lechk82/ledctrl/schematics/ledctrl.pdf

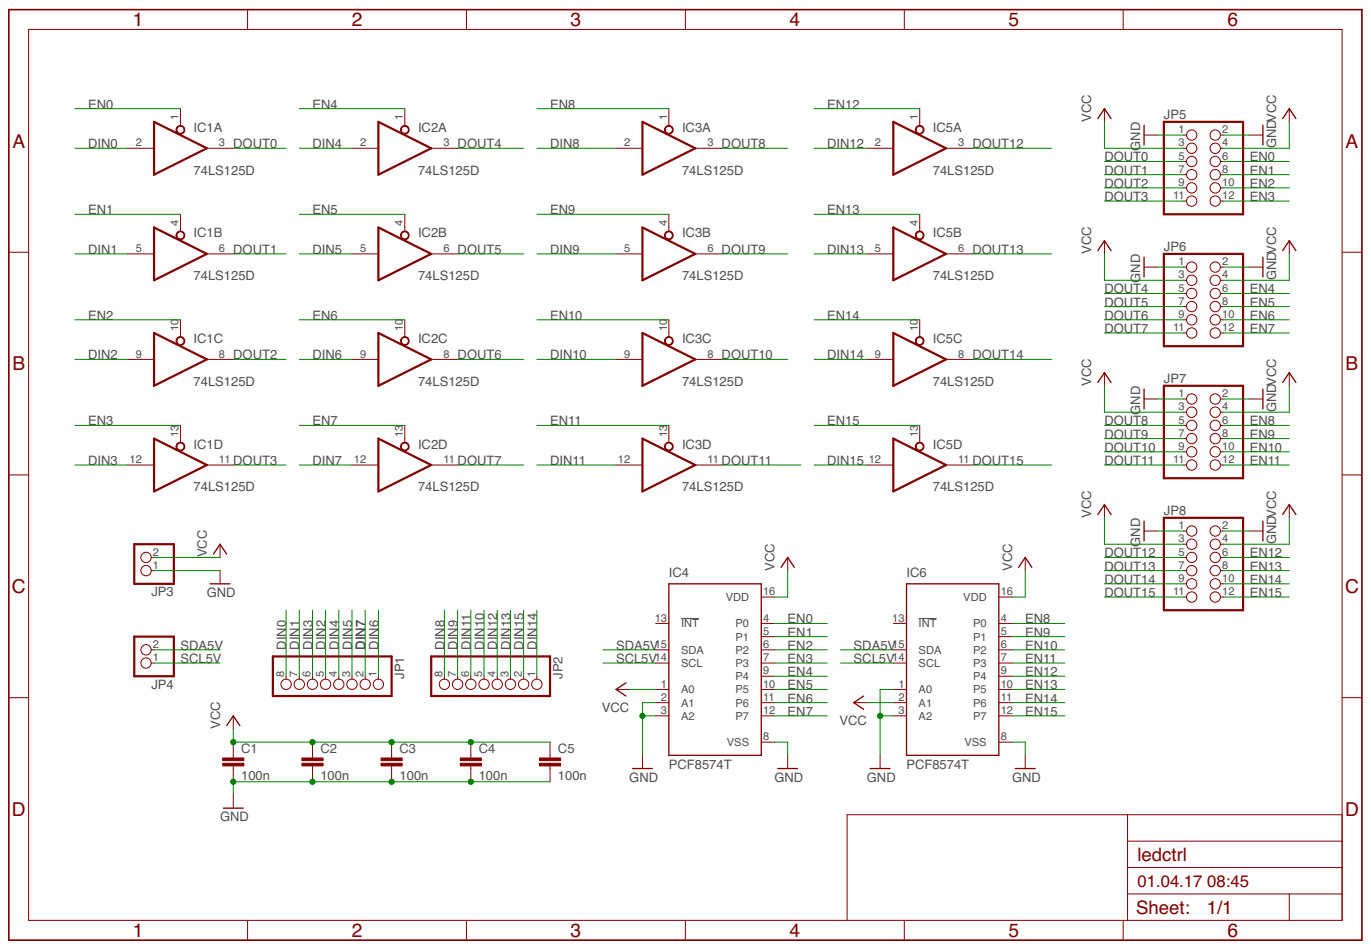
[picture p1: page 1]

GND GND
