lechk82/ledctrl/schematics/ledctrl_carrier.pdf

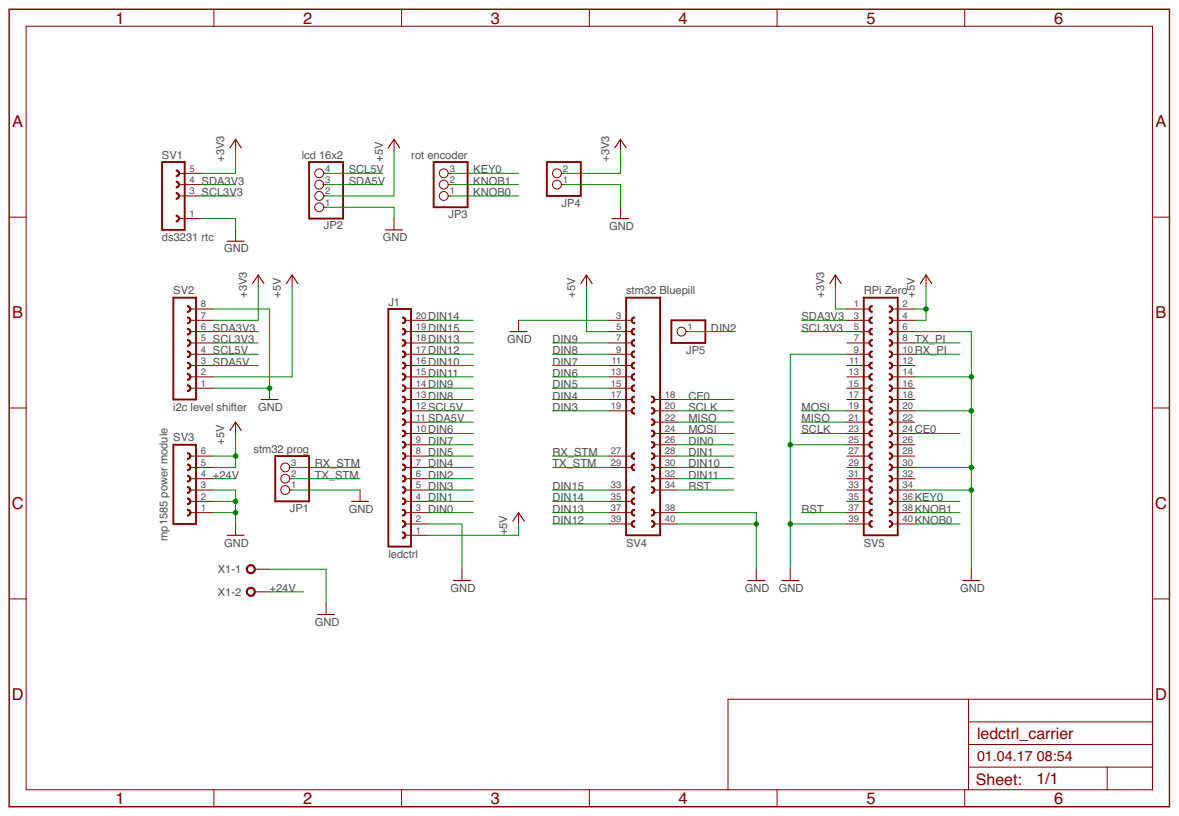
[picture p2: page 1]
