lechk82/ledctrl/schematics/ledctrl_driver.pdf

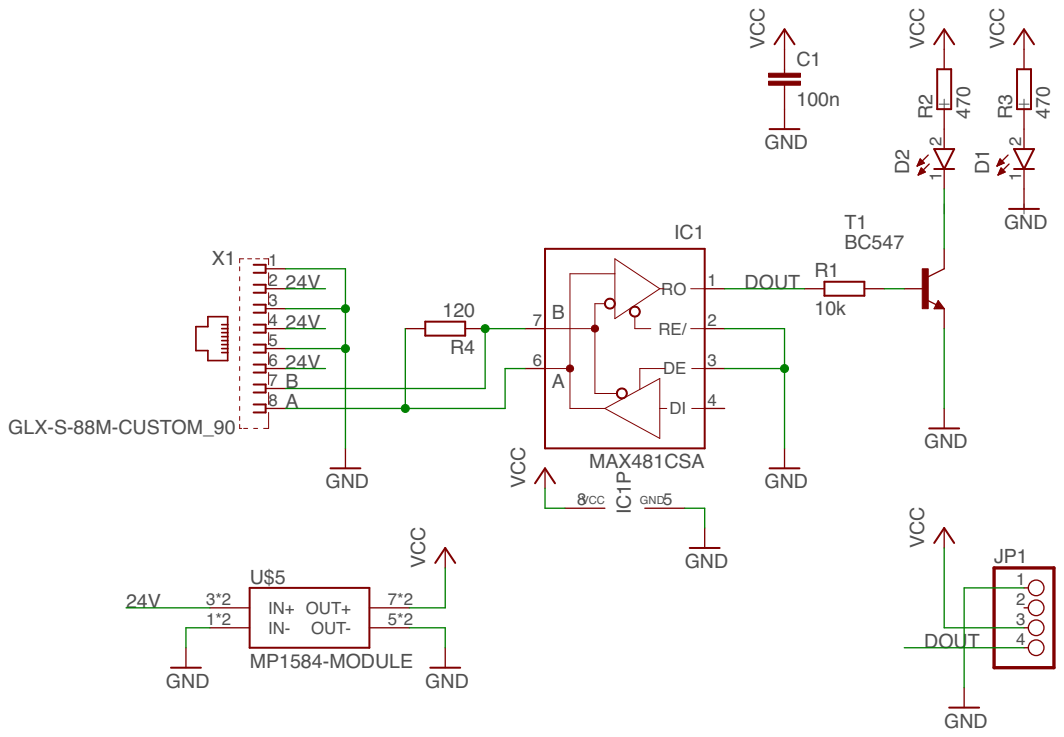
[picture p3: page 1]
