lechk82/ledctrl/schematics/ledctrl_output.pdf

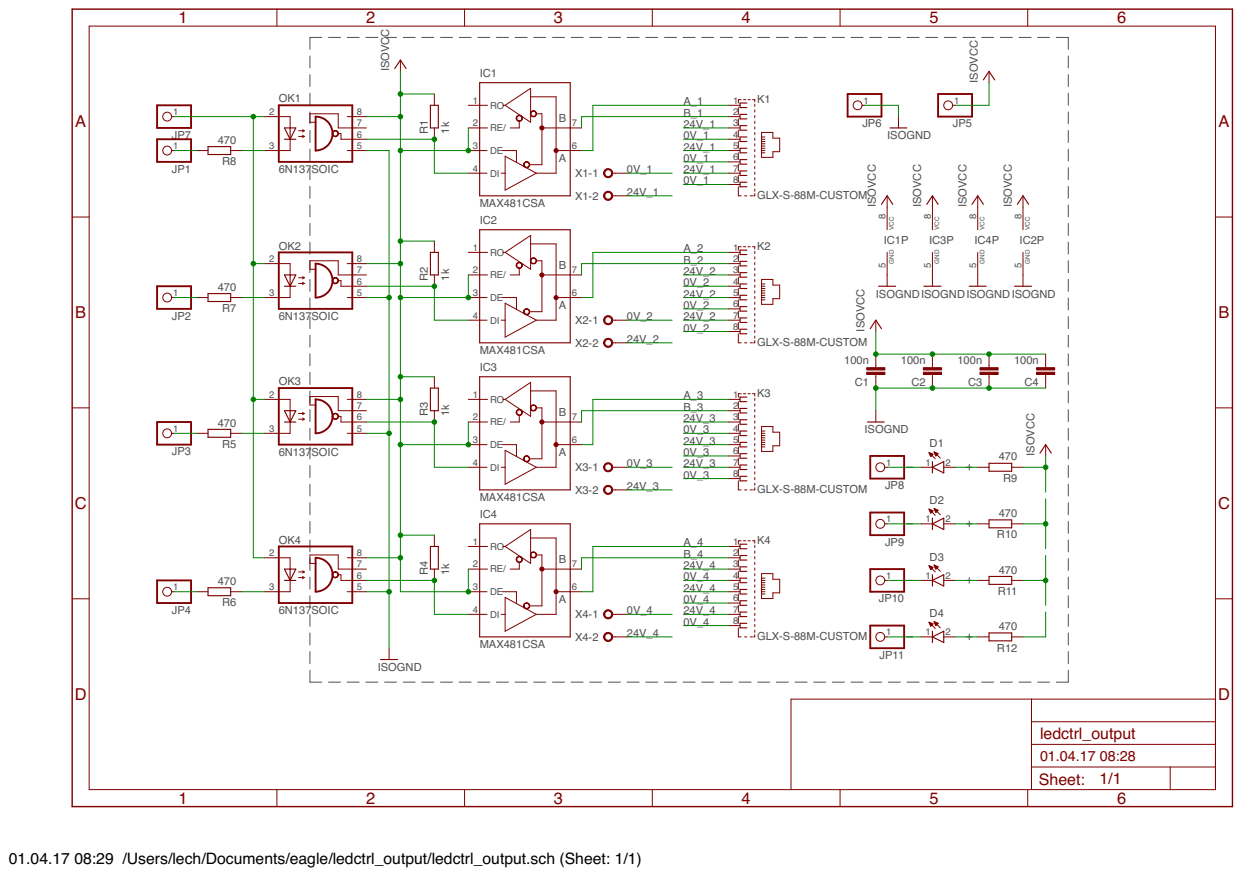
[picture p4: page 1]
