lechk82/ledctrl/(commit log)

2017-02-22 stm32 arduino added
2017-04-01 schematics added
